riky192/STM32_pedalboard/Kicad/stm32_board.kicad_sch

## KiCad design Kicad/stm32_board.kicad_sch (2024-04-29)

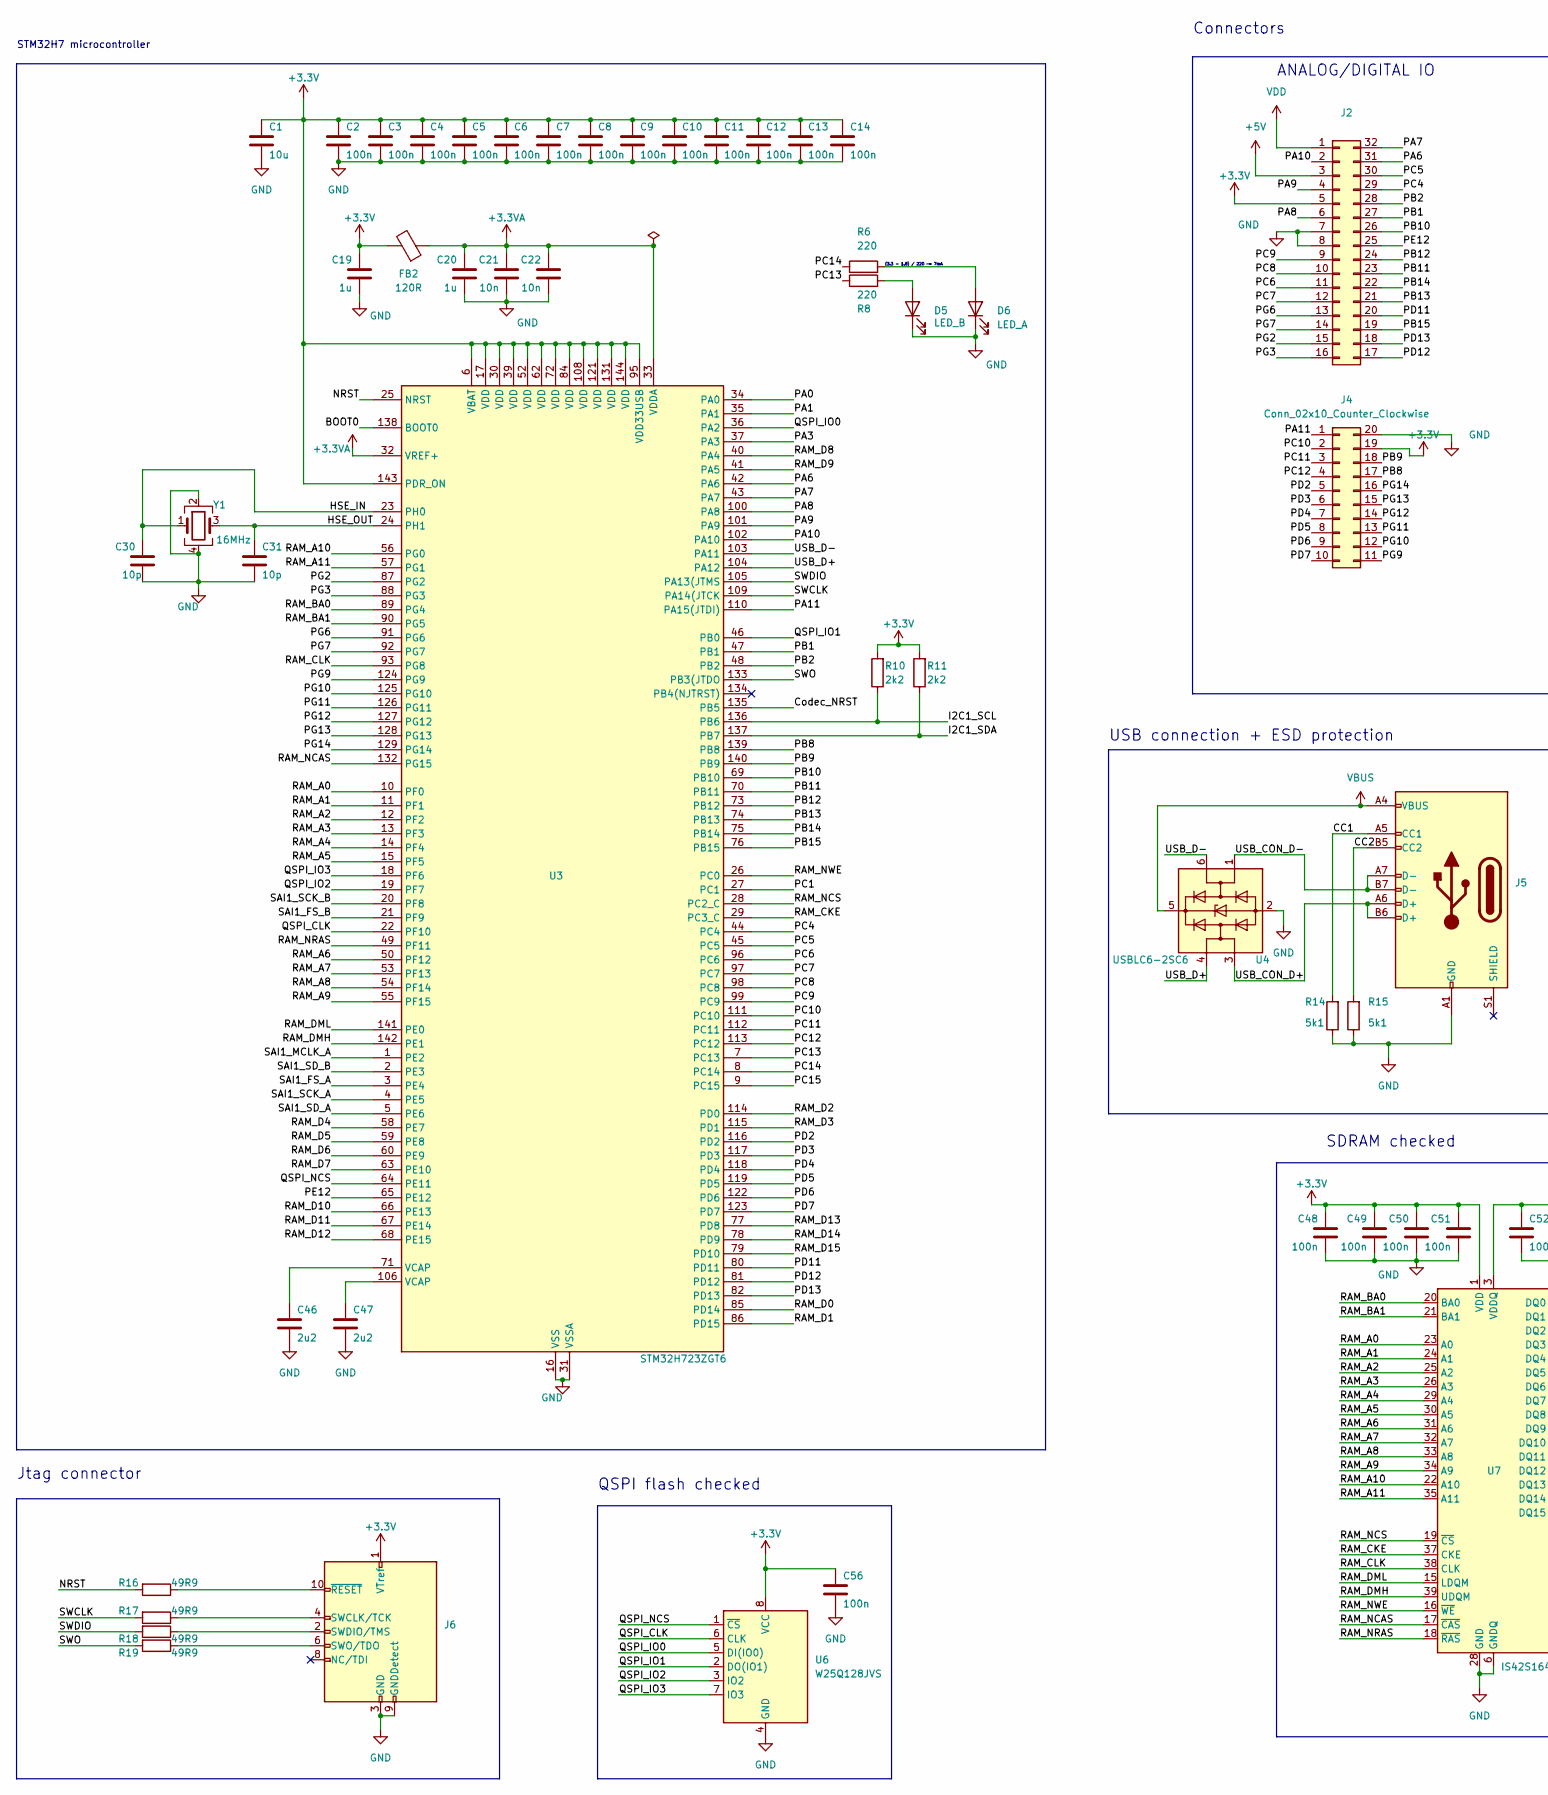
[picture p1: schematic stm32_board.kicad_sch, part in row 1, column 1]

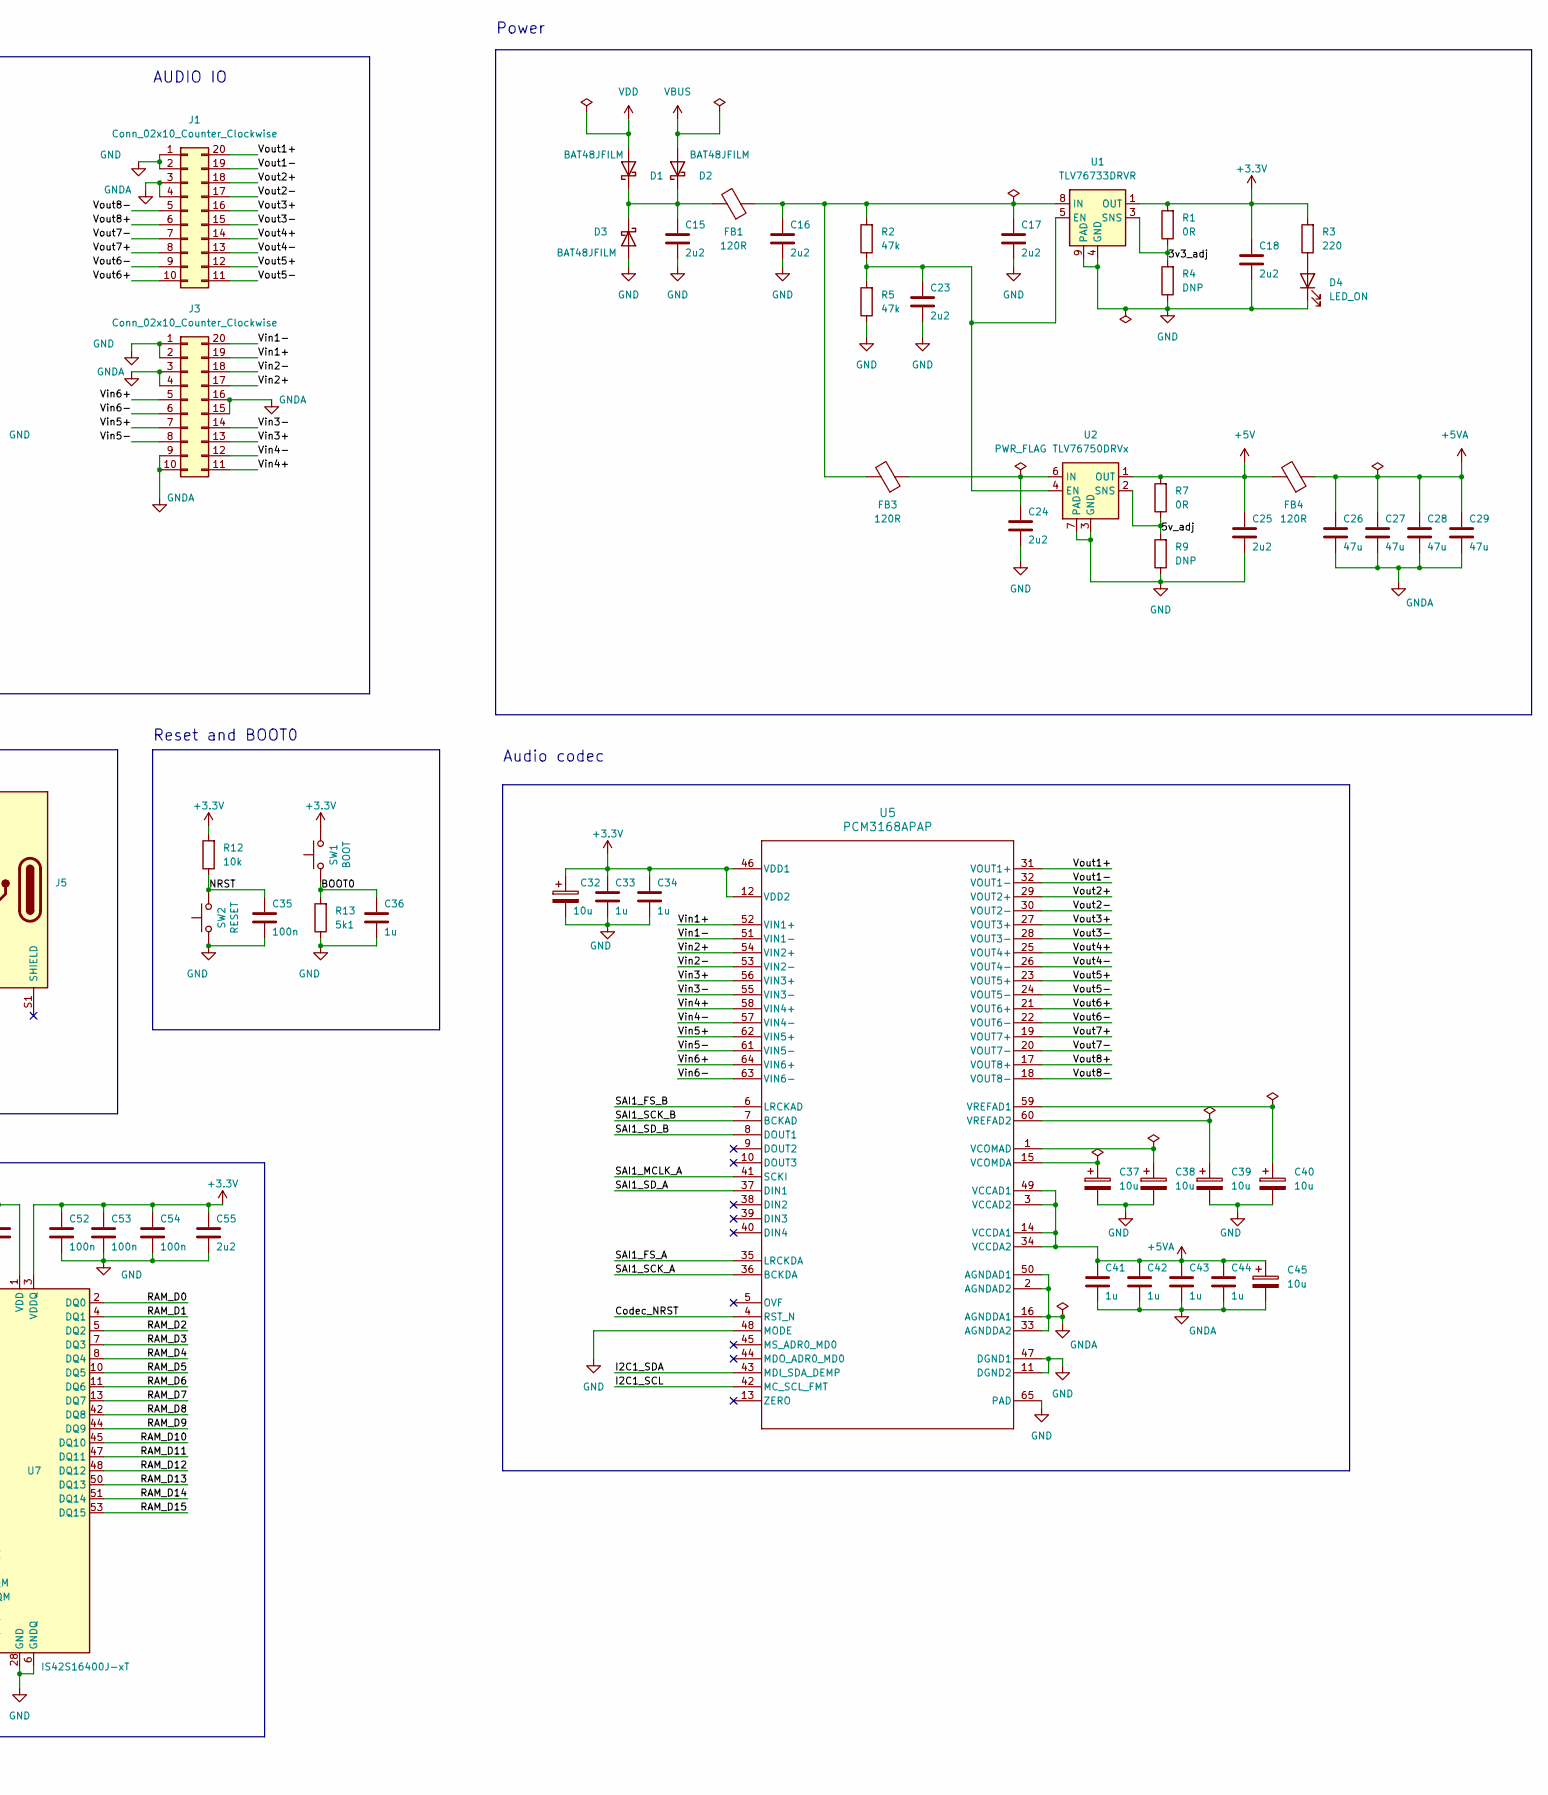
[picture p2: schematic stm32_board.kicad_sch, part in row 1, column 2]

Parts:
C1, C32, C37, C38, C39, C40, C45: 10u; C_0603_1608Metric_Pad1.08x0.95mm_HandSolder; MANUFACTURER_PART_NUMBER C19702
C2, C3, C4, C5, C6, C7, C8, C9, C10, C11, C12, C13, C14, C35, C48, C49, C50, C51, C52, C53, C54, C56: 100n; C_0603_1608Metric_Pad1.08x0.95mm_HandSolder; MANUFACTURER_PART_NUMBER C14663
C15, C16, C17, C18, C23, C24, C25, C46, C47, C55: 2u2; C_1206_3216Metric_Pad1.33x1.80mm_HandSolder; MANUFACTURER_PART_NUMBER C50254
C19, C20, C33, C34, C36, C41, C42, C43, C44: 1u; C_0603_1608Metric_Pad1.08x0.95mm_HandSolder; MANUFACTURER_PART_NUMBER C15849
C21, C22: 10n; C_0603_1608Metric_Pad1.08x0.95mm_HandSolder; MANUFACTURER_PART_NUMBER C57112
C26, C27, C28, C29: 47u; C_0805_2012Metric_Pad1.18x1.45mm_HandSolder; MANUFACTURER_PART_NUMBER C45783
C30, C31: 10p; C_0603_1608Metric_Pad1.08x0.95mm_HandSolder; MANUFACTURER_PART_NUMBER C1634
D1, D2, D3: BAT48JFILM; D_SOD-323; MANUFACTURER_PART_NUMBER C191023
D4: LED_ON; LED_0805_2012Metric_Pad1.15x1.40mm_HandSolder; MANUFACTURER_PART_NUMBER C2296
D5: LED_B; LED_0805_2012Metric_Pad1.15x1.40mm_HandSolder; MANUFACTURER_PART_NUMBER C5879378
D6: LED_A; LED_0805_2012Metric_Pad1.15x1.40mm_HandSolder; MANUFACTURER_PART_NUMBER C5879378
FB1, FB2, FB3, FB4: 120R; L_0805_2012Metric_Pad1.05x1.20mm_HandSolder; MANUFACTURER_PART_NUMBER C1015
J1, J3, J4: Conn_02x10_Counter_Clockwise; PinHeader_2x10_P2.54mm_Vertical
J2: Conn_02x16_Counter_Clockwise; PinHeader_2x16_P2.54mm_Vertical
J5: USB_C_Receptacle_USB2.0_14P; USB_C_Receptacle_GCT_USB4105-xx-A_16P_TopMnt_Horizontal
J6: Conn_ARM_JTAG_SWD_10; PinHeader_2x05_P1.27mm_Vertical_SMD
R1, R7: 0R; R_0603_1608Metric_Pad0.98x0.95mm_HandSolder; MANUFACTURER_PART_NUMBER C21189
R2, R5: 47k; R_0603_1608Metric_Pad0.98x0.95mm_HandSolder; MANUFACTURER_PART_NUMBER C25819
R3, R6, R8: 220; R_0603_1608Metric_Pad0.98x0.95mm_HandSolder; MANUFACTURER_PART_NUMBER C22962
R4, R9: DNP; R_0603_1608Metric_Pad0.98x0.95mm_HandSolder
R10, R11: 2k2; R_0603_1608Metric_Pad0.98x0.95mm_HandSolder; MANUFACTURER_PART_NUMBER C4190
R12: 10k; R_0603_1608Metric_Pad0.98x0.95mm_HandSolder; MANUFACTURER_PART_NUMBER C25804
R13, R14, R15: 5k1; R_0603_1608Metric_Pad0.98x0.95mm_HandSolder; MANUFACTURER_PART_NUMBER C23186
R16, R17, R18, R19: 49R9; R_0603_1608Metric_Pad0.98x0.95mm_HandSolder; MANUFACTURER_PART_NUMBER C23185
SW1: BOOT; SW_Push_1P1T_XKB_TS-1187A; MANUFACTURER_PART_NUMBER C318884
SW2: RESET; SW_Push_1P1T_XKB_TS-1187A; MANUFACTURER_PART_NUMBER C318884
U1: TLV76733DRVR; VSON-8-1EP_3x3mm_P0.65mm_EP1.65x2.4mm; MANUFACTURER_PART_NUMBER C2848334
U2: TLV76750DRVx; WSON-6-1EP_2x2mm_P0.65mm_EP1x1.6mm_ThermalVias; MANUFACTURER_PART_NUMBER C2860264
U3: STM32H723ZGT6; LQFP-144_20x20mm_P0.5mm; MANUFACTURER_PART_NUMBER C730146
U4: USBLC6-2SC6; SOT-23-6; MANUFACTURER_PART_NUMBER C2687116
U5: PCM3168APAP; PAP0064J_fixed; MANUFACTURER_PART_NUMBER C529289
U6: W25Q128JVS; SOIC-8_5.23x5.23mm_P1.27mm; MANUFACTURER_PART_NUMBER C2613930
U7: IS42S16400J-xT; TSOP-II-54_22.2x10.16mm_P0.8mm; MANUFACTURER_PART_NUMBER C2897490
Y1: 16MHz; Oscillator_SMD_Abracon_ASE-4Pin_3.2x2.5mm_HandSoldering; MANUFACTURER_PART_NUMBER C13738

Connections:
3v3_adj: R1.1, R4.2, U1.3 (SNS)
5v_adj: R7.1, R9.2, U2.2 (SNS)
+3.3V: C1.1, C2.1, C3.1, C4.1, C5.1, C6.1, C7.1, C8.1, C9.1, C10.1, C11.1, C12.1, C13.1, C14.1, C18.1, C19.1, C32.1, C33.1, C34.1, C48.1, C49.1, C50.1, C51.1, C52.1, C53.1, C54.1, C55.1, C56.1, FB2.2, J2.5, J4.19, J6.1 (VTref), R1.2, R3.2, R10.2, R11.2, R12.2, SW1.1, U1.1 (OUT), U3.6 (VBAT), U3.17 (VDD), U3.30 (VDD), U3.39 (VDD), U3.52 (VDD), U3.62 (VDD), U3.72 (VDD), U3.84 (VDD), U3.95 (VDD33USB), U3.108 (VDD), U3.121 (VDD), U3.131 (VDD), U3.143 (PDR_ON), U3.144 (VDD), U5.12 (VDD2), U5.46 (VDD1), U6.8 (VCC), U7.1 (VDD), U7.3 (VDDQ), U7.9 (VDDQ), U7.14 (VDD), U7.27 (VDD), U7.43 (VDDQ), U7.49 (VDDQ)
+3.3VA: C20.1, C21.1, C22.1, FB2.1, U3.32 (VREF+), U3.33 (VDDA)
+5V: C25.1, FB4.2, J2.3, R7.2, U2.1 (OUT)
+5VA: C26.1, C27.1, C28.1, C29.1, C41.1, C42.1, C43.1, C44.1, C45.1, FB4.1, U5.3 (VCCAD2), U5.14 (VCCDA1), U5.34 (VCCDA2), U5.49 (VCCAD1)
BOOT0: C36.1, R13.2, SW1.2, U3.138 (BOOT0)
CC1: J5.A5 (CC1), R14.2
CC2: J5.B5 (CC2), R15.2
Codec_NRST: U3.135 (PB5), U5.4 (RST_N)
GND: C1.2, C2.2, C3.2, C4.2, C5.2, C6.2, C7.2, C8.2, C9.2, C10.2, C11.2, C12.2, C13.2, C14.2, C15.2, C16.2, C17.2, C18.2, C19.2, C20.2, C21.2, C22.2, C23.2, C24.2, C25.2, C30.2, C31.2, C32.2, C33.2, C34.2, C35.2, C36.2, C37.2, C38.2, C39.2, C40.2, C46.2, C47.2, C48.2, C49.2, C50.2, C51.2, C52.2, C53.2, C54.2, C55.2, C56.2, D3.2 (A), D4.1 (K), D5.1 (K), D6.1 (K), J1.1, J1.2, J2.7, J2.8, J3.1, J3.2, J4.20, J5.A1 (GND), J5.A12 (GND), J5.B1 (GND), J5.B12 (GND), J6.3 (GND), J6.5 (GND), J6.9 (GNDDetect), R4.1, R5.1, R9.1, R13.1, R14.1, R15.1, SW2.2, U1.4 (GND), U1.6 (GND), U1.9 (PAD), U2.3 (GND), U2.5 (GND), U2.7 (PAD), U3.16 (VSS), U3.31 (VSSA), U3.38 (VSS), U3.51 (VSS), U3.61 (VSS), U3.83 (VSS), U3.94 (VSS), U3.107 (VSS), U3.120 (VSS), U3.130 (VSS), U4.2 (GND), U5.11 (DGND2), U5.47 (DGND1), U5.48 (MODE), U5.65 (PAD), U6.4 (GND), U7.6 (GNDQ), U7.12 (GNDQ), U7.28 (GND), U7.41 (GND), U7.46 (GNDQ), U7.52 (GNDQ), U7.54 (GND), Y1.2, Y1.4
GNDA: C26.2, C27.2, C28.2, C29.2, C41.2, C42.2, C43.2, C44.2, C45.2, J1.3, J1.4, J3.3, J3.4, J3.9, J3.10, J3.15, J3.16, U5.2 (AGNDAD2), U5.16 (AGNDDA1), U5.33 (AGNDDA2), U5.50 (AGNDAD1)
HSE_IN: C30.1, U3.23 (PH0), Y1.1
HSE_OUT: C31.1, U3.24 (PH1), Y1.3
I2C1_SCL: R10.1, U3.136 (PB6), U5.42 (MC_SCL_FMT)
I2C1_SDA: R11.1, U3.137 (PB7), U5.43 (MDI_SDA_DEMP)
NRST: C35.1, R12.1, R16.2, SW2.1, U3.25 (NRST)
unnamed: C15.1, D1.1 (K), D2.1 (K), D3.1 (K), FB1.2
unnamed: C16.1, C17.1, FB1.1, FB3.2, R2.2, U1.8 (IN)
unnamed: C23.1, R2.1, R5.2, U1.5 (EN), U2.4 (EN)
unnamed: C24.1, FB3.1, U2.6 (IN)
unnamed: C37.1, U5.15 (VCOMDA)
unnamed: C38.1, U5.1 (VCOMAD)
unnamed: C39.1, U5.60 (VREFAD2)
unnamed: C40.1, U5.59 (VREFAD1)
unnamed: C46.1, U3.71 (VCAP)
unnamed: C47.1, U3.106 (VCAP)
unnamed: D4.2 (A), R3.1
unnamed: D5.2 (A), R8.2
unnamed: D6.2 (A), R6.2
unnamed: J6.2 (SWDIO/TMS), R18.1
unnamed: J6.4 (SWCLK/TCK), R17.1
unnamed: J6.6 (SWO/TDO), R19.1
unnamed: J6.10 (~RESET), R16.1
PA0: U3.34 (PA0)
PA1: U3.35 (PA1)
PA3: U3.37 (PA3)
PA6: J2.31, U3.42 (PA6)
PA7: J2.32, U3.43 (PA7)
PA8: J2.6, U3.100 (PA8)
PA9: J2.4, U3.101 (PA9)
PA10: J2.2, U3.102 (PA10)
PA11: J4.1, U3.110 (PA15(JTDI))
PB1: J2.27, U3.47 (PB1)
PB2: J2.28, U3.48 (PB2)
PB8: J4.17, U3.139 (PB8)
PB9: J4.18, U3.140 (PB9)
PB10: J2.26, U3.69 (PB10)
PB11: J2.23, U3.70 (PB11)
PB12: J2.24, U3.73 (PB12)
PB13: J2.21, U3.74 (PB13)
PB14: J2.22, U3.75 (PB14)
PB15: J2.19, U3.76 (PB15)
PC1: U3.27 (PC1)
PC4: J2.29, U3.44 (PC4)
PC5: J2.30, U3.45 (PC5)
PC6: J2.11, U3.96 (PC6)
PC7: J2.12, U3.97 (PC7)
PC8: J2.10, U3.98 (PC8)
PC9: J2.9, U3.99 (PC9)
PC10: J4.2, U3.111 (PC10)
PC11: J4.3, U3.112 (PC11)
PC12: J4.4, U3.113 (PC12)
PC13: R8.1, U3.7 (PC13)
PC14: R6.1, U3.8 (PC14)
PC15: U3.9 (PC15)
PD2: J4.5, U3.116 (PD2)
PD3: J4.6, U3.117 (PD3)
PD4: J4.7, U3.118 (PD4)
PD5: J4.8, U3.119 (PD5)
PD6: J4.9, U3.122 (PD6)
PD7: J4.10, U3.123 (PD7)
PD11: J2.20, U3.80 (PD11)
PD12: J2.17, U3.81 (PD12)
PD13: J2.18, U3.82 (PD13)
PE12: J2.25, U3.65 (PE12)
PG2: J2.15, U3.87 (PG2)
PG3: J2.16, U3.88 (PG3)
PG6: J2.13, U3.91 (PG6)
PG7: J2.14, U3.92 (PG7)
PG9: J4.11, U3.124 (PG9)
PG10: J4.12, U3.125 (PG10)
PG11: J4.13, U3.126 (PG11)
PG12: J4.14, U3.127 (PG12)
PG13: J4.15, U3.128 (PG13)
PG14: J4.16, U3.129 (PG14)
QSPI_CLK: U3.22 (PF10), U6.6 (CLK)
QSPI_IO0: U3.36 (PA2), U6.5 (DI(IO0))
QSPI_IO1: U3.46 (PB0), U6.2 (DO(IO1))
QSPI_IO2: U3.19 (PF7), U6.3 (IO2)
QSPI_IO3: U3.18 (PF6), U6.7 (IO3)
QSPI_NCS: U3.64 (PE11), U6.1 (~CS)
RAM_A0: U3.10 (PF0), U7.23 (A0)
RAM_A1: U3.11 (PF1), U7.24 (A1)
RAM_A2: U3.12 (PF2), U7.25 (A2)
RAM_A3: U3.13 (PF3), U7.26 (A3)
RAM_A4: U3.14 (PF4), U7.29 (A4)
RAM_A5: U3.15 (PF5), U7.30 (A5)
RAM_A6: U3.50 (PF12), U7.31 (A6)
RAM_A7: U3.53 (PF13), U7.32 (A7)
RAM_A8: U3.54 (PF14), U7.33 (A8)
RAM_A9: U3.55 (PF15), U7.34 (A9)
RAM_A10: U3.56 (PG0), U7.22 (A10)
RAM_A11: U3.57 (PG1), U7.35 (A11)
RAM_BA0: U3.89 (PG4), U7.20 (BA0)
RAM_BA1: U3.90 (PG5), U7.21 (BA1)
RAM_CKE: U3.29 (PC3_C), U7.37 (CKE)
RAM_CLK: U3.93 (PG8), U7.38 (CLK)
RAM_D0: U3.85 (PD14), U7.2 (DQ0)
RAM_D1: U3.86 (PD15), U7.4 (DQ1)
RAM_D2: U3.114 (PD0), U7.5 (DQ2)
RAM_D3: U3.115 (PD1), U7.7 (DQ3)
RAM_D4: U3.58 (PE7), U7.8 (DQ4)
RAM_D5: U3.59 (PE8), U7.10 (DQ5)
RAM_D6: U3.60 (PE9), U7.11 (DQ6)
RAM_D7: U3.63 (PE10), U7.13 (DQ7)
RAM_D8: U3.40 (PA4), U7.42 (DQ8)
RAM_D9: U3.41 (PA5), U7.44 (DQ9)
RAM_D10: U3.66 (PE13), U7.45 (DQ10)
RAM_D11: U3.67 (PE14), U7.47 (DQ11)
RAM_D12: U3.68 (PE15), U7.48 (DQ12)
RAM_D13: U3.77 (PD8), U7.50 (DQ13)
RAM_D14: U3.78 (PD9), U7.51 (DQ14)
RAM_D15: U3.79 (PD10), U7.53 (DQ15)
RAM_DMH: U3.142 (PE1), U7.39 (UDQM)
RAM_DML: U3.141 (PE0), U7.15 (LDQM)
RAM_NCAS: U3.132 (PG15), U7.17 (~CAS)
RAM_NCS: U3.28 (PC2_C), U7.19 (~CS)
RAM_NRAS: U3.49 (PF11), U7.18 (~RAS)
RAM_NWE: U3.26 (PC0), U7.16 (~WE)
SAI1_FS_A: U3.3 (PE4), U5.35 (LRCKDA)
SAI1_FS_B: U3.21 (PF9), U5.6 (LRCKAD)
SAI1_MCLK_A: U3.1 (PE2), U5.41 (SCKI)
SAI1_SCK_A: U3.4 (PE5), U5.36 (BCKDA)
SAI1_SCK_B: U3.20 (PF8), U5.7 (BCKAD)
SAI1_SD_A: U3.5 (PE6), U5.37 (DIN1)
SAI1_SD_B: U3.2 (PE3), U5.8 (DOUT1)
SWCLK: R17.2, U3.109 (PA14(JTCK)
SWDIO: R18.2, U3.105 (PA13(JTMS)
SWO: R19.2, U3.133 (PB3(JTDO)
USB_CON_D+: J5.A6 (D+), J5.B6 (D+), U4.3 (I/O2)
USB_CON_D-: J5.A7 (D-), J5.B7 (D-), U4.1 (I/O1)
USB_D+: U3.104 (PA12), U4.4 (I/O2)
USB_D-: U3.103 (PA11), U4.6 (I/O1)
VBUS: D2.2 (A), J5.A4 (VBUS), J5.A9 (VBUS), J5.B4 (VBUS), J5.B9 (VBUS), U4.5 (VBUS)
VDD: D1.2 (A), J2.1
Vin1+: J3.19, U5.52 (VIN1+)
Vin1-: J3.20, U5.51 (VIN1-)
Vin2+: J3.17, U5.54 (VIN2+)
Vin2-: J3.18, U5.53 (VIN2-)
Vin3+: J3.13, U5.56 (VIN3+)
Vin3-: J3.14, U5.55 (VIN3-)
Vin4+: J3.11, U5.58 (VIN4+)
Vin4-: J3.12, U5.57 (VIN4-)
Vin5+: J3.7, U5.62 (VIN5+)
Vin5-: J3.8, U5.61 (VIN5-)
Vin6+: J3.5, U5.64 (VIN6+)
Vin6-: J3.6, U5.63 (VIN6-)
Vout1+: J1.20, U5.31 (VOUT1+)
Vout1-: J1.19, U5.32 (VOUT1-)
Vout2+: J1.18, U5.29 (VOUT2+)
Vout2-: J1.17, U5.30 (VOUT2-)
Vout3+: J1.16, U5.27 (VOUT3+)
Vout3-: J1.15, U5.28 (VOUT3-)
Vout4+: J1.14, U5.25 (VOUT4+)
Vout4-: J1.13, U5.26 (VOUT4-)
Vout5+: J1.12, U5.23 (VOUT5+)
Vout5-: J1.11, U5.24 (VOUT5-)
Vout6+: J1.10, U5.21 (VOUT6+)
Vout6-: J1.9, U5.22 (VOUT6-)
Vout7+: J1.8, U5.19 (VOUT7+)
Vout7-: J1.7, U5.20 (VOUT7-)
Vout8+: J1.6, U5.17 (VOUT8+)
Vout8-: J1.5, U5.18 (VOUT8-)

Notes on the sheet:
Power
Jtag connector
(3.3 - 1.8) / 220 ~= 7mA
SDRAM checked
AUDIO IO
STM32H7 microcontroller
Connectors
QSPI flash checked
ANALOG/DIGITAL IO
USB connection + ESD protection
Audio codec
Reset and BOOT0
