riky192/STM32_pedalboard/Test1/Test1.ioc

Mcu.UserName=STM32H723ZGTx
PA13(JTMS/SWDIO).Signal=DEBUG_JTMS-SWDIO
PA14(JTCK/SWCLK).Signal=DEBUG_JTCK-SWCLK
PB3(JTDO/TRACESWO).Signal=DEBUG_JTDO-SWO
PB6.Signal=I2C1_SCL
PB7.Signal=I2C1_SDA
PC13.Signal=GPIO_Output
PC14-OSC32_IN.Signal=GPIO_Output
PC8.Signal=GPIO_Output
PE2.Signal=SAI1_MCLK_A
PE3.Signal=SAI1_SD_B
PE4.Signal=SAI1_FS_A
PE5.Signal=SAI1_SCK_A
PE6.Signal=SAI1_SD_A
PF8.Signal=SAI1_SCK_B
PF9.Signal=SAI1_FS_B
PH0-OSC_IN.Signal=RCC_OSC_IN
PH1-OSC_OUT.Signal=RCC_OSC_OUT
